OldSurferDude/Soil-Moisture-Sensor-remote-battery-solar/Remote Solar Powered (with battery backup) Soil Moisture Sensor Bill of Materials.xlsx

Part Number | qty | units | source qty | description | source | notes
U1 | 1 | ea | 10 | soil moisture sensor | https://www.amazon.com/Capacitive-Soil-Moisture-Sensor-Electronic/dp/B0B8N69LMX/ref=sr_1_1 | Includes jumper wires (see pn JW) | Capacitive Soil Moisture Sensors don't work correctly + Fix for v2.0 v1.2 Arduino ESP32 Raspberry Pi (https://www.youtube.com/watch?v=IGP38bz-K48)
U2 | 1 | ea |  | RF nano | https://www.aliexpress.us/item/3256807986944972.html | header pins will have to be removed
U3 | 1 | ea | 10 | TP4056 Battery Management Board | https://www.amazon.com/HiLetgo-Lithium-Battery-Charging-Protect/dp/B00LTQU2RK
B1 | 1 | ea |  | 18650 battery | Amazon.com: Yuntunele 2 Packs 18650 Rechargeable Battery 3.7V 3500mAh 18650 Button Top Battery for Headlights etc : Electronics (https://www.amazon.com/Yuntunele-Replacement-Battery-Rechargeable-Headlights/dp/B0CSW8525D) | A low mAh version may be adequate due to the low energy consumption
Bh | 1 | ea | 10 | Battery holder | https://www.aliexpress.us/item/3256804898031489.html | minimum mAh required is about 1000.
JW | 3 | ea |  | jumper wire | see pn U1 | can be used without modification
PS1 | 1 | ea | 3 | Solar panel | https://www.amazon.com/dp/B08332319P | 3 units in source
~~J1-J6~~ | ~~8~~ |  | ~~20~~ | ~~wire connectors~~ | ~~https://www.aliexpress.us/item/3256806866154919.html~~ | ~~wire must be soldered to the connector :(~~
~~wire~~ |  |  |  | ~~24AWG~~ |  | ~~length depends on distance between soil sensor and solar panel (wire from ethernet cable?)~~
tape | 10 | mm | 10 | Double stick tape | https://www.amazon.com/Urethane-Adhesion-Polyurethane-Attaching-Nameplates/dp/B0D128W9B1
glue | 0.1 | g | 12 tubes of 2g | super glue | https://www.amazon.com/dp/B000LGPD64
Sealant | 5 | ml | 118 | liquid tape | https://www.homedepot.com/p/Star-brite-4-oz-Liquid-Electrical-Tape-Black-084104N/206513456 | is removeable to allow repair
J9-15 | 4 | pair | 200 | angle double pin header | https://www.amazon.com/Uxcell-a15010500ux0918-2-54mm-20-pin-Double/dp/B00W8TSWXS
connecting wire | 7 | ea | 120 (3 sets of 40) | Dupont Wire 20cm: M-F, F-F, M-M | https://www.amazon.com/Elegoo-EL-CP-004-Multicolored-Breadboard-arduino/dp/B01EV70C78
insulator | 6 | ea | 120 x 4 | Heat shrink Tubing 2mm x 10mm | https://www.amazon.com/dp/B07WWWPR2X | More than needed, check other sources
corrosion prevention | 0.2 | oz | 11 | Clear Lacquer | https://www.amazon.com/Sprayon-ELECTRICAL-LACQUER-Aerosol-S02000000/dp/B00DRHSFCS
3D printed parts
sensor tube | 1
sensor keeper | 1
nano tube | 1
1/2" NTP connector | 1
coupler | 2
battery tube | 1
cross piece | 1
mount | 1
panel bracket | 1
M5x10 + nut | 1 |  |  |  |  | SS M5x10 and SS M5 nut may be used.
